bungernut/nEXO_Thermometry/pcb/thermo.kicad_pcb

## KiCad design pcb/thermo.kicad_pcb (2022-02-16)

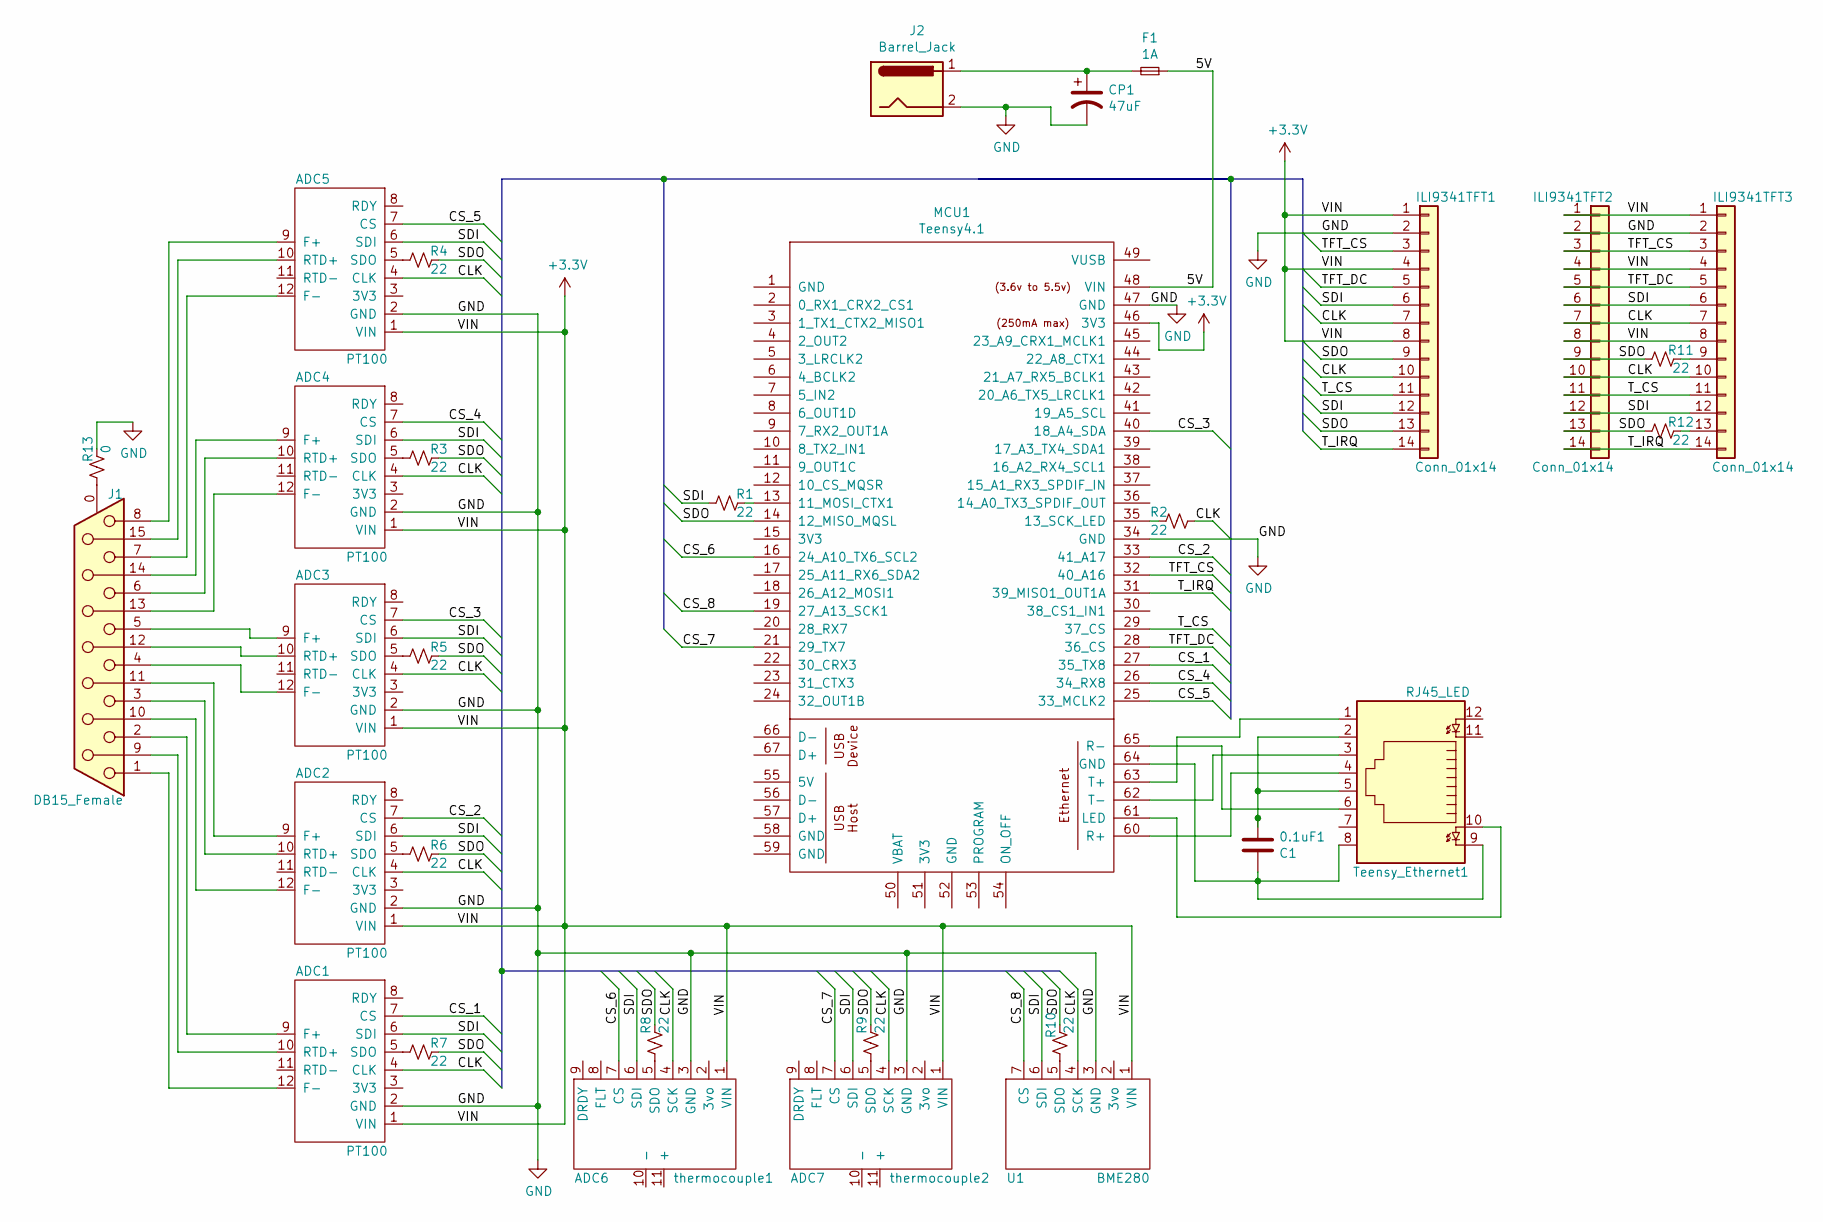
[picture p1: schematic thermo.sch]

Parts:
0.1uF1: C1; C_Disc_D3.0mm_W1.6mm_P2.50mm
ADC1, ADC2, ADC3, ADC4, ADC5: PT100; MAX31865
ADC6: thermocouple1; MAX31856
ADC7: thermocouple2; MAX31856
CP1: 47uF; CP_Radial_D5.0mm_P2.00mm
F1: 1A; thermo_fuse
ILI9341TFT1, ILI9341TFT2: Conn_01x14; ILI9341_2x7_connector
ILI9341TFT3: Conn_01x14; ILI9341_1x14_connector
J1: DB15_Female; D15_Female_Horizontal
J2: Barrel_Jack; BarrelJack_Horizontal
MCU1: Teensy4.1; Teensy41
R1, R2, R3, R4, R5, R6, R7, R8, R9, R10, R11, R12: 22; R_0805_2012Metric_Pad1.20x1.40mm_HandSolder
R13: 0; R_0805_2012Metric_Pad1.20x1.40mm_HandSolder
Teensy_Ethernet1: RJ45_LED; RJ45_Cetus_J1B1211CCD_Horizontal
U1: BME280

Connections:
+3V3: ADC1.1 (VIN), ADC2.1 (VIN), ADC3.1 (VIN), ADC4.1 (VIN), ADC5.1 (VIN), ADC6.1 (VIN), ADC7.1 (VIN), ILI9341TFT1.1, ILI9341TFT1.4, ILI9341TFT1.8, ILI9341TFT2.1, ILI9341TFT2.4, ILI9341TFT2.8, ILI9341TFT3.1, ILI9341TFT3.4, ILI9341TFT3.8, MCU1.46 (3V3), U1.1 (VIN)
/5V: F1.1, MCU1.48 (VIN)
/CLK: ADC1.4 (CLK), ADC2.4 (CLK), ADC3.4 (CLK), ADC4.4 (CLK), ADC5.4 (CLK), ADC6.4 (SCK), ADC7.4 (SCK), ILI9341TFT1.7, ILI9341TFT1.10, ILI9341TFT2.7, ILI9341TFT2.10, ILI9341TFT3.7, ILI9341TFT3.10, R2.1, U1.4 (SCK)
/CS_1: ADC1.7 (CS), MCU1.27 (35_TX8)
/CS_2: ADC2.7 (CS), MCU1.33 (41_A17)
/CS_3: ADC3.7 (CS), MCU1.40 (18_A4_SDA)
/CS_4: ADC4.7 (CS), MCU1.26 (34_RX8)
/CS_5: ADC5.7 (CS), MCU1.25 (33_MCLK2)
/CS_6: ADC6.7 (CS), MCU1.16 (24_A10_TX6_SCL2)
/CS_7: ADC7.7 (CS), MCU1.21 (29_TX7)
/CS_8: MCU1.19 (27_A13_SCK1), U1.7 (CS)
/SDI: ADC1.6 (SDI), ADC2.6 (SDI), ADC3.6 (SDI), ADC4.6 (SDI), ADC5.6 (SDI), ADC6.6 (SDI), ADC7.6 (SDI), ILI9341TFT1.6, ILI9341TFT1.12, ILI9341TFT2.6, ILI9341TFT2.12, ILI9341TFT3.6, ILI9341TFT3.12, R1.2, U1.6 (SDI)
/SDO: ILI9341TFT1.9, ILI9341TFT1.13, ILI9341TFT2.9, ILI9341TFT2.13, MCU1.14 (12_MISO_MQSL), R3.1, R4.1, R5.1, R6.1, R7.1, R8.1, R9.1, R10.1, R11.2, R12.2
/TFT_CS: ILI9341TFT1.3, ILI9341TFT2.3, ILI9341TFT3.3, MCU1.32 (40_A16)
/TFT_DC: ILI9341TFT1.5, ILI9341TFT2.5, ILI9341TFT3.5, MCU1.28 (36_CS)
/T_CS: ILI9341TFT1.11, ILI9341TFT2.11, ILI9341TFT3.11, MCU1.29 (37_CS)
/T_IRQ: ILI9341TFT1.14, ILI9341TFT2.14, ILI9341TFT3.14, MCU1.31 (39_MISO1_OUT1A)
GND: ADC1.2 (GND), ADC2.2 (GND), ADC3.2 (GND), ADC4.2 (GND), ADC5.2 (GND), ADC6.3 (GND), ADC7.3 (GND), CP1.2, ILI9341TFT1.2, ILI9341TFT2.2, ILI9341TFT3.2, J2.2, MCU1.34 (GND), MCU1.47 (GND), R13.1, U1.3 (GND)
unnamed: 0.1uF1.1, Teensy_Ethernet1.2, Teensy_Ethernet1.5
unnamed: 0.1uF1.2, MCU1.64 (GND), Teensy_Ethernet1.8, Teensy_Ethernet1.9
unnamed: ADC1.5 (SDO), R7.2
unnamed: ADC1.9 (F+), J1.2
unnamed: ADC1.10 (RTD+), J1.9
unnamed: ADC1.12 (F-), J1.1
unnamed: ADC2.5 (SDO), R6.2
unnamed: ADC2.9 (F+), J1.11 (P111)
unnamed: ADC2.10 (RTD+), J1.3
unnamed: ADC2.12 (F-), J1.10
unnamed: ADC3.5 (SDO), R5.2
unnamed: ADC3.9 (F+), J1.5
unnamed: ADC3.10 (RTD+), J1.12
unnamed: ADC3.12 (F-), J1.4
unnamed: ADC4.5 (SDO), R3.2
unnamed: ADC4.9 (F+), J1.14
unnamed: ADC4.10 (RTD+), J1.6
unnamed: ADC4.12 (F-), J1.13
unnamed: ADC5.5 (SDO), R4.2
unnamed: ADC5.9 (F+), J1.8
unnamed: ADC5.10 (RTD+), J1.15
unnamed: ADC5.12 (F-), J1.7
unnamed: ADC6.5 (SDO), R8.2
unnamed: ADC7.5 (SDO), R9.2
unnamed: CP1.1, F1.2, J2.1
unnamed: ILI9341TFT3.9, R11.1
unnamed: ILI9341TFT3.13, R12.1
unnamed: J1.0 (PAD), R13.2
unnamed: MCU1.13 (11_MOSI_CTX1), R1.1
unnamed: MCU1.35 (13_SCK_LED), R2.2
unnamed: MCU1.60 (R+), Teensy_Ethernet1.4
unnamed: MCU1.61 (LED), Teensy_Ethernet1.10
unnamed: MCU1.62 (T-), Teensy_Ethernet1.3
unnamed: MCU1.63 (T+), Teensy_Ethernet1.1
unnamed: MCU1.65 (R-), Teensy_Ethernet1.6
unnamed: R10.2, U1.5 (SDO)

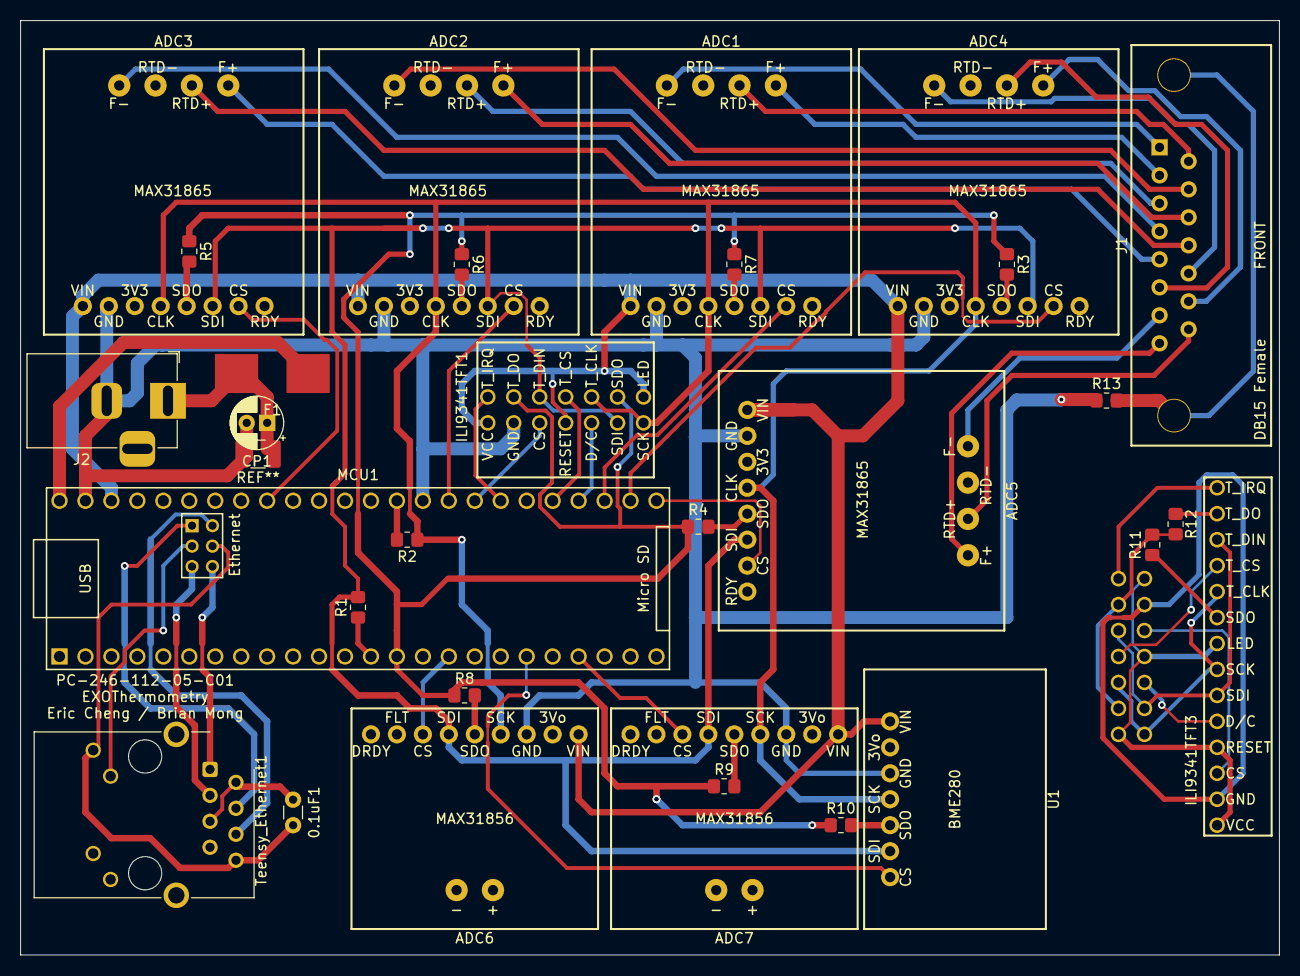
[picture p2: board thermo.kicad_pcb from above]

Board: 2 copper layers, 123.2 x 91.4 mm, 31 parts (1 on the bottom side), 54 nets.
