bungernut/nEXO_Thermometry/(commit log)

2022-02-16 fixed MAX31865 sensor side pinout mixup, new layout on OSHPark V2
    [thermo.kicad_pcb]
2022-02-22 Update README.md
    Updating to new board and adding some documentation
2022-02-22 Added watchdog to hopefully reset if ever frozen
    [teensy_tft.ino]
2022-02-23 Still debugging WDT, definetly still broken
    [teensy_tft.ino]
2022-04-13 debugging, but the main issue was probably on nodered side
    [teensy_tft.ino]
